DanielDalPra/Mundo-Senai-IOT/referencias/Código da Maquete - Estoque Inteligente.docx

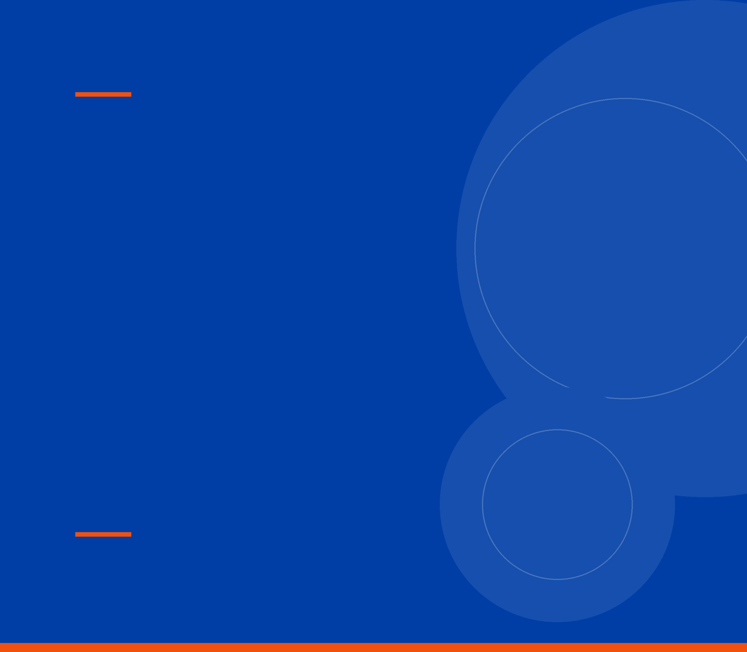
[picture p2: figure]
Fundo azul decorativo da capa

SERVIÇO NACIONAL DE APRENDIZAGEM INDUSTRIAL

Código
da Maquete

Estoque Inteligente com ESP32
Código-fonte e tabela de conexões

UNIDADE

Chapecó

CURSO

Técnico de Desenvolvimento de Sistemas

ALUNOS

Ana Júlia Cabral dos Santos, Crisbeth León, Catherine Bolivar, Mariana Lehr de Oliveira e Yoná Hellen de Sousa

DOCENTE

Rafaela Moreno

Chapecó

2026

# 1. Visão geral

Este documento reúne o código do ESP32 do projeto Estoque Inteligente e a tabela geral de conexões da maquete. O código é apresentado exatamente como foi desenvolvido pelo grupo, sem nenhuma alteração, e mantém o padrão de cores do arquivo original.

Item | Descrição
Microcontrolador | ESP32
Linguagem | C/C++ (Arduino)
Bibliotecas | SPI, Adafruit GFX, Adafruit SSD1306 e MFRC522
Periféricos | Display OLED SSD1306 (SPI), leitor RFID RC522 (SPI), ultrassônico HC-SR04 e sensor de cor TCS3200
Monitor Serial | 115200 baud
Intervalos de leitura | Ultrassônico: 500 ms · Cor: 1000 ms · RFID: 300 ms
Tamanho do código | 234 linhas

# 2. Tabela geral de conexões do ESP32

Componente | Pino no Componente | Pino no ESP32 | Tipo / Função Eletrônica | Status no Projeto
Alimentação Geral | VCC (Geral) | 3V3 ou 5V (Ver nota) | Alimentação Positiva | Obrigatório
| GND (Geral) | GND | Terra / Negativo Comum | Obrigatório
Display OLED (SPI) | CLK / D0 | GPIO 18 | SPI Clock (Compartilhado) | Sua ligação exata
| MOSI / DATA / D1 | GPIO 23 | SPI MOSI (Compartilhado) | Sua ligação exata
| CS | GPIO 4 | Chip Select (Exclusivo OLED) | Sua ligação exata
| DC | GPIO 27 | Data/Command (Exclusivo OLED) | Sua ligação exata
| RES / RESET | Nenhum (ou RST/EN) | Reset por Hardware (Opcional) | Definido como flutuante/=-1
Leitor RFID (SPI) | SCK / CLK | GPIO 18 | SPI Clock (Compartilhado) | Ligação compartilhada
| MOSI | GPIO 23 | SPI MOSI (Compartilhado) | Ligação compartilhada
| MISO | GPIO 19 | SPI MISO (Exclusivo RFID) | Obrigatório p/ retorno de dados
| SDA / CS | GPIO 12 | Chip Select (Exclusivo RFID) | Sugerido livre
| RST | GPIO 14 | Reset de Hardware (Exclusivo) | Sugerido livre
Ultrassônico (HC-SR04) | TRIG | GPIO 15 (D15) | Saída Digital (Pulso de disparo) | Sua ligação final
| ECHO | GPIO 26 (D26) | Entrada Digital (Retorno do eco) | Sua ligação final
Sensor de Cor (TCS3200) | S0 | GPIO 32 | Saída Digital (Escala de Frequência) | Sugerido livre
| S1 | GPIO 33 | Saída Digital (Escala de Frequência) | Sugerido livre
| S2 | GPIO 25 | Saída Digital (Seleção de Filtro) | Sugerido livre
| S3 | GPIO 13 | Saída Digital (Seleção de Filtro) | Sugerido livre
| OUT | GPIO 34 | Entrada Digital Pura (Leitura Freq.) | Sugerido livre (Input-only)
| LED | 3V3 ou GND | Alimentação dos LEDs integrados | Apenas um lado (Sua escolha)

# 3. Código-fonte

O código abaixo está idêntico ao do arquivo original, com o mesmo padrão de cores.

Cor | Exemplo | Elemento
■■■ | #include, if | Diretivas e comandos de controle
■■■ | int, float, void | Tipos de dados e modificadores
■■■ | Serial, digitalWrite | Funções, objetos e constantes
■■■ | 500, "VERMELHO" | Números e textos
■■■ | // comentário | Comentários
■■■ | x = y; ( ) { } | Variáveis, operadores e pontuação

#include <SPI.h>

#include <Adafruit_GFX.h>

#include <Adafruit_SSD1306.h>

#include <MFRC522.h>

// --- Configurações do Display OLED SPI ---

#define SCREEN_WIDTH 128

#define SCREEN_HEIGHT 64

#define OLED_MOSI 23

#define OLED_CLK 18

#define OLED_DC 27

#define OLED_CS 4

#define OLED_RESET -1

Adafruit_SSD1306 display(SCREEN_WIDTH, SCREEN_HEIGHT, &SPI, OLED_DC, OLED_RESET, OLED_CS);

// --- Configurações do Leitor RFID SPI ---

#define RFID_SDA_CS 12

#define RFID_RST 14

#define SPI_MISO 19

MFRC522 rfid(RFID_SDA_CS, RFID_RST);

// --- Configurações do Sensor Ultrassônico HC-SR04 ---

const int trigPin = 15;

const int echoPin = 26;

#define SOUND_SPEED 0.034

// --- Configurações do Sensor de Cor TCS3200 ---

#define S0 32

#define S1 33

#define S2 25

#define S3 13

#define sensorOut 34 // GPIO 34 é perfeito pois é uma entrada pura (Input-only)

// Variáveis para armazenar as frequências lidas pelo TCS3200

int frequenciaVermelho = 0;

int frequenciaVerde = 0;

int frequenciaAzul = 0;

// --- Variáveis de controle de tempo com millis() ---

unsigned long tempoAnteriorUltrassonico = 0;

const long intervaloUltrassonico = 500;

unsigned long tempoAnteriorRFID = 0;

const long intervaloRFID = 300;

unsigned long tempoAnteriorCor = 0;

const long intervaloCor = 1000; // Lê a cor a cada 1 segundo quando a caixa estiver presente

bool caixaPresente = false;

String corDetectada = "Nenhuma";

void setup() {

Serial.begin(115200);

// Inicializa o barramento SPI

SPI.begin(OLED_CLK, SPI_MISO, OLED_MOSI, -1);

// Inicialização do Display OLED

if(!display.begin(SSD1306_SWITCHCAPVCC)) {

Serial.println(F("Falha ao inicializar o display SSD1306"));

for(;;);

}

// Inicialização do Leitor RFID

rfid.PCD_Init();

// Inicialização dos pinos do Ultrassônico

pinMode(trigPin, OUTPUT);

pinMode(echoPin, INPUT);

// Inicialização dos pinos do TCS3200

pinMode(S0, OUTPUT);

pinMode(S1, OUTPUT);

pinMode(S2, OUTPUT);

pinMode(S3, OUTPUT);

pinMode(sensorOut, INPUT);

// Configura a escala de frequência do TCS3200 para 20% (S0 HIGH, S1 LOW)

// É a escala ideal e mais estável para leitura no ESP32

digitalWrite(S0, HIGH);

digitalWrite(S1, LOW);

// Tela Inicial

display.clearDisplay();

display.setTextSize(1);

display.setTextColor(SSD1306_WHITE);

display.setCursor(10, 25);

display.println("AGUARDANDO CAIXA...");

display.display();

}

void loop() {

unsigned long tempoAtual = millis();

// 1. Controle de tempo do Ultrassônico (A cada 500ms)

if (tempoAtual - tempoAnteriorUltrassonico >= intervaloUltrassonico) {

tempoAnteriorUltrassonico = tempoAtual;

float distancia = lerDistancia();

if (distancia > 0 && distancia < 4.0) {

if (!caixaPresente) {

caixaPresente = true;

Serial.println("Caixa detectada!");

atualizarDisplayMensagem("CAIXA DETECTADA", "Processando item...");

}

} else {

if (caixaPresente) {

caixaPresente = false;

corDetectada = "Nenhuma";

Serial.println("Caixa removida.");

atualizarDisplayMensagem("ESTOQUE LIVRE", "Aguardando caixa...");

}

}

}

// Se a caixa estiver presente na vaga, ativa as outras leituras de forma ritmada

if (caixaPresente) {

// 2. Leitura do Sensor de Cor (A cada 1 segundo)

if (tempoAtual - tempoAnteriorCor >= intervaloCor) {

tempoAnteriorCor = tempoAtual;

corDetectada = lerCorTCS3200();

// Atualiza a tela mostrando que a caixa está presente e exibindo a cor atualizada

atualizarDisplayMensagem("CAIXA NA VAGA", "Cor: " + corDetectada + "\nAproxime o RFID...");

}

// 3. Leitura do RFID (A cada 300ms)

if (tempoAtual - tempoAnteriorRFID >= intervaloRFID) {

tempoAnteriorRFID = tempoAtual;

lerRFID();

}

}

}

// ==========================================

// FUNÇÃO PARA ATUALIZAR MENSAGENS NO OLED

// ==========================================

void atualizarDisplayMensagem(String titulo, String subtitulo) {

display.clearDisplay();

display.setTextSize(1);

display.setCursor(0, 10);

display.println(titulo);

display.drawFastHLine(0, 25, 128, SSD1306_WHITE);

display.setCursor(0, 35);

display.println(subtitulo);

display.display();

}

// ==========================================

// FUNÇÃO PARA LER O SENSOR ULTRASSÔNICO

// ==========================================

float lerDistancia() {

digitalWrite(trigPin, LOW);

delayMicroseconds(2);

digitalWrite(trigPin, HIGH);

delayMicroseconds(10);

digitalWrite(trigPin, LOW);

long duracao = pulseIn(echoPin, HIGH, 26000);

if (duracao == 0) return -1.0;

return (duracao * SOUND_SPEED) / 2.0;

}

// ==========================================

// FUNÇÃO PARA LER O SENSOR DE COR TCS3200

// ==========================================

String lerCorTCS3200() {

// Nota: Menor frequência calculada pelo pulseIn significa maior intensidade daquela cor.

// Configura filtro Vermelho (S2 LOW, S3 LOW)

digitalWrite(S2, LOW);

digitalWrite(S3, LOW);

frequenciaVermelho = pulseIn(sensorOut, LOW, 20000); // timeout de 20ms

// Configura filtro Verde (S2 HIGH, S3 HIGH)

digitalWrite(S2, HIGH);

digitalWrite(S3, HIGH);

frequenciaVerde = pulseIn(sensorOut, LOW, 20000);

// Configura filtro Azul (S2 LOW, S3 HIGH)

digitalWrite(S2, LOW);

digitalWrite(S3, HIGH);

frequenciaAzul = pulseIn(sensorOut, LOW, 20000);

// --- LÓGICA DE CALIBRAÇÃO E IDENTIFICAÇÃO ---

// IMPORTANTE: Você precisará ajustar os valores abaixo olhando o Monitor Serial,

// pois a iluminação do ambiente altera muito o comportamento do TCS3200.

Serial.print("R: "); Serial.print(frequenciaVermelho);

Serial.print(" | G: "); Serial.print(frequenciaVerde);

Serial.print(" | B: "); Serial.println(frequenciaAzul);

// Exemplo básico de decisão lógica de cor baseado no menor valor de frequência (predominância)

if (frequenciaVermelho < frequenciaVerde && frequenciaVermelho < frequenciaAzul) {

return "VERMELHO";

}

else if (frequenciaAzul < frequenciaVermelho && frequenciaAzul < frequenciaVerde) {

return "AZUL";

}

else if (frequenciaVerde < frequenciaVermelho && frequenciaVerde < frequenciaAzul) {

return "VERDE";

}

return "Indefinida";

}

// ==========================================

// FUNÇÃO PARA LER O LEITOR RFID

// ==========================================

void lerRFID() {

if ( ! rfid.PICC_IsNewCardPresent()) return;

if ( ! rfid.PICC_ReadCardSerial()) return;

Serial.print("Tag RFID Detectada! UID: ");

String uidString = "";

for (byte i = 0; i < rfid.uid.size; i++) {

uidString += String(rfid.uid.uidByte[i] < 0x10 ? " 0" : " ");

uidString += String(rfid.uid.uidByte[i], HEX);

}

uidString.toUpperCase();

Serial.println(uidString);

// Quando ler o RFID, mostra o UID junto com a cor que já estava armazenada

atualizarDisplayMensagem("TAG LIDA!", "UID:" + uidString + "\nCor: " + corDetectada);

rfid.PICC_HaltA();

rfid.PCD_StopCrypto1();

}

Código-fonte do sistema

SENAI Código da maquete · Estoque Inteligente
