DanielDalPra/Mundo-Senai-IOT/docs/esp32-usb-conectado.png

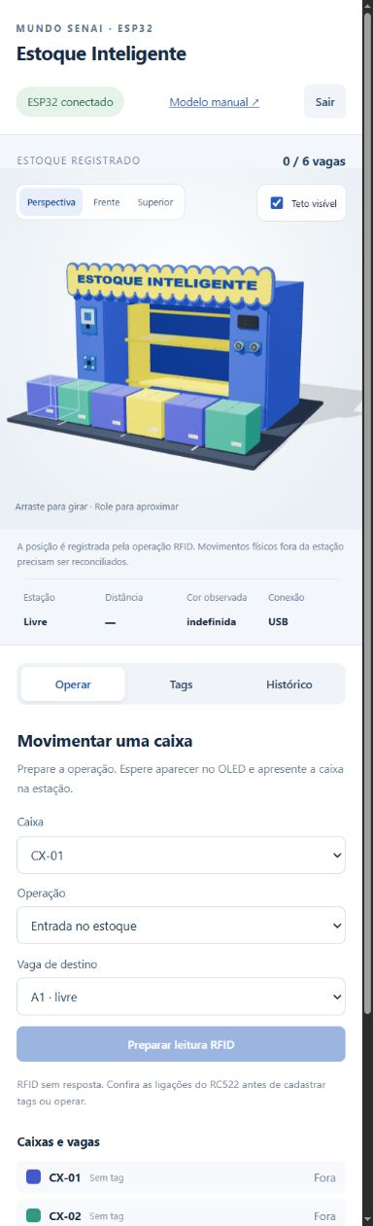
docs/esp32-usb-conectado.png
