DanielDalPra/Mundo-Senai-IOT/referencias/fotos-maquete/WhatsApp Image 2026-10-21 at 19.43.03.jpeg

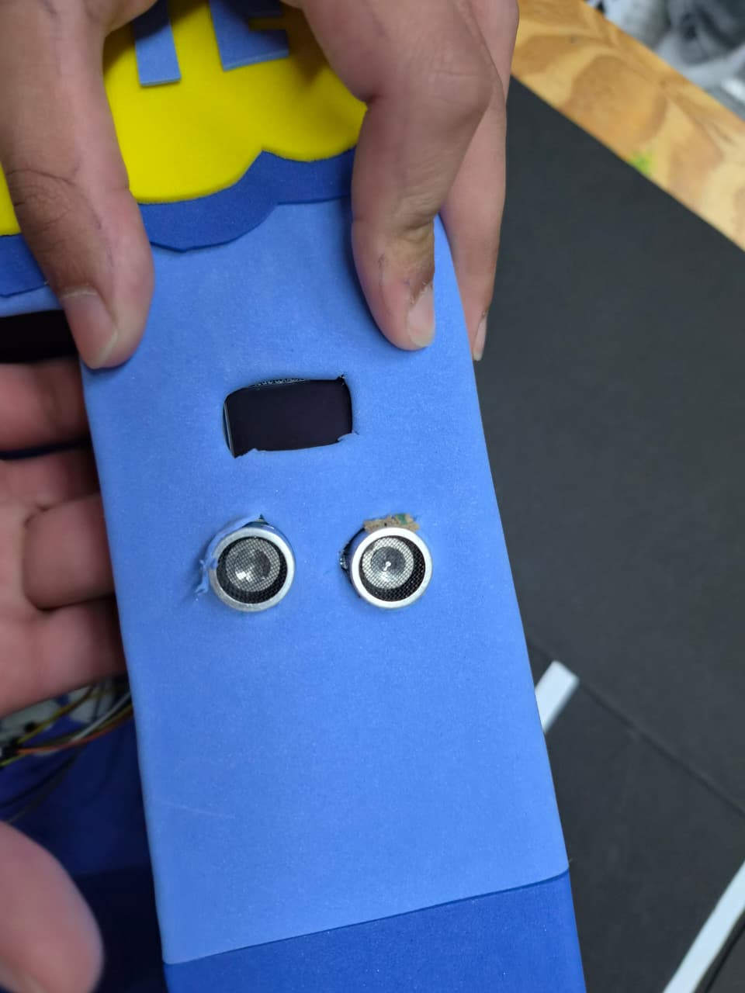
referencias/fotos-maquete/WhatsApp Image 2026-10-21 at 19.43.03.jpeg
