DanielDalPra/Mundo-Senai-IOT/referencias/componentes/WhatsApp Image 2026-10-21 at 19.54.55.jpeg

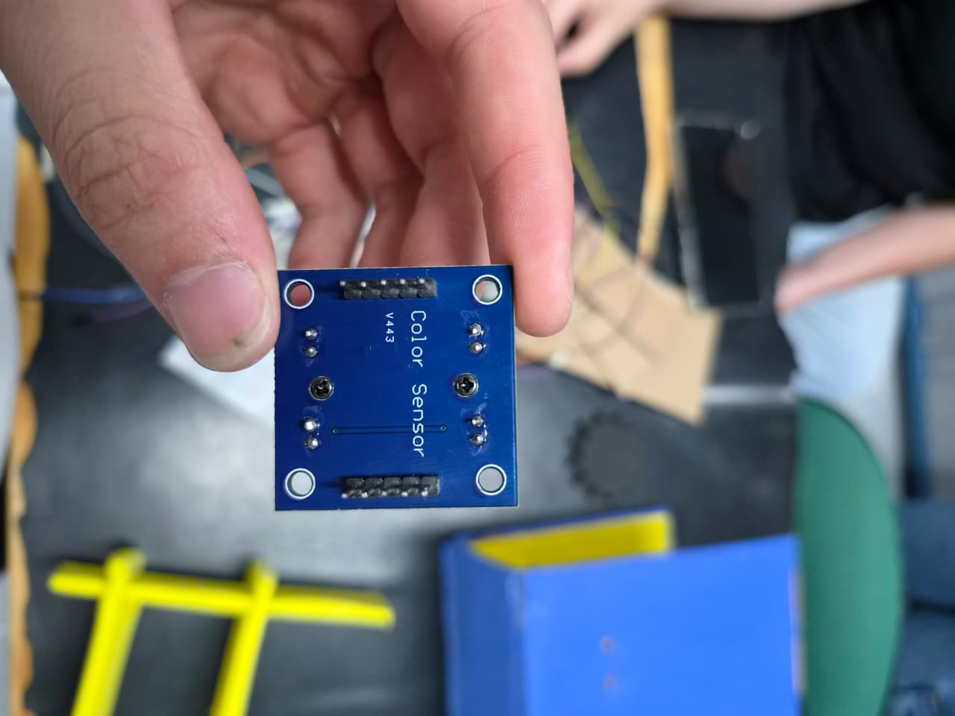
referencias/componentes/WhatsApp Image 2026-10-21 at 19.54.55.jpeg
