DanielDalPra/Mundo-Senai-IOT/docs/montagem-fiel.png

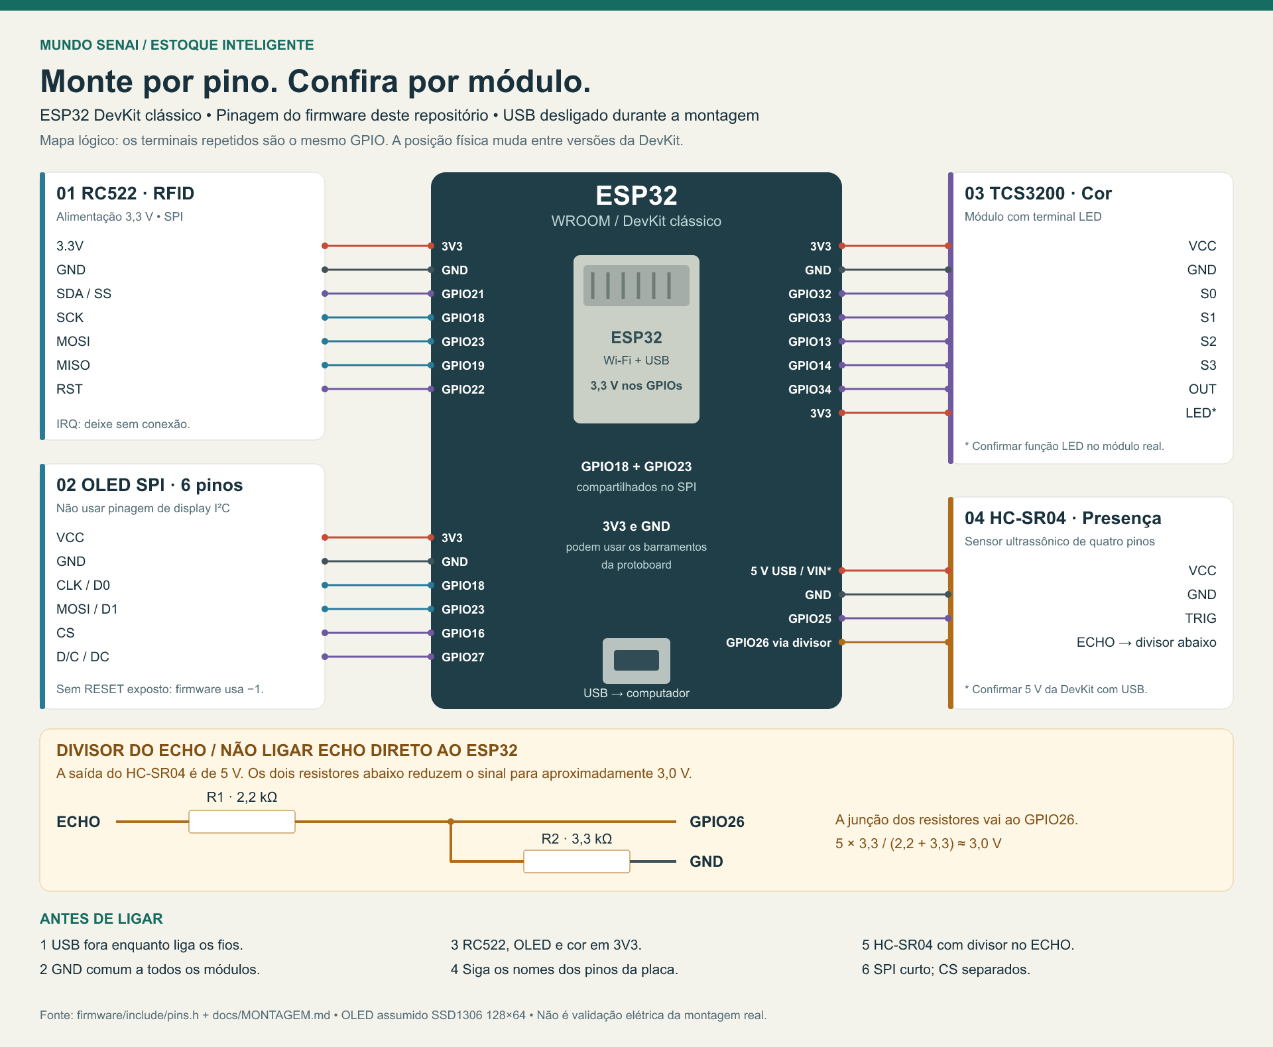
docs/montagem-fiel.png
