DanielDalPra/Mundo-Senai-IOT/simulation/wokwi/circuito-testado.png

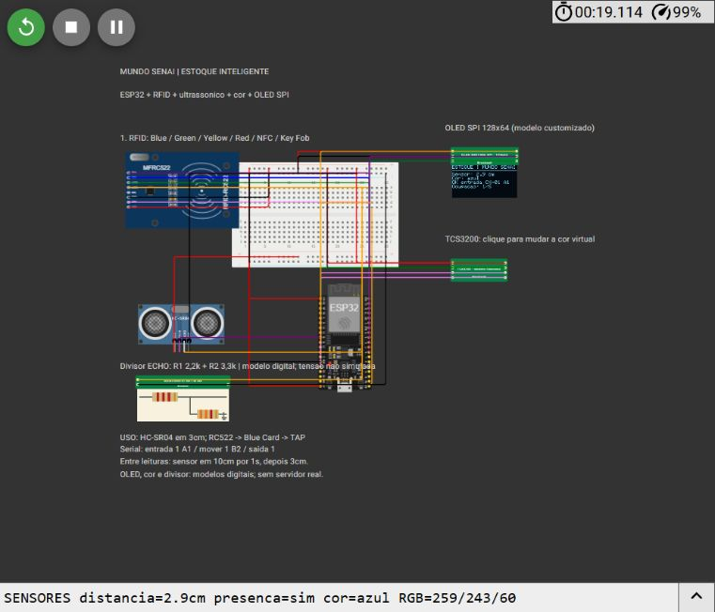
simulation/wokwi/circuito-testado.png
