DanielDalPra/Mundo-Senai-IOT/simulation/wokwi/teste-rfid.png

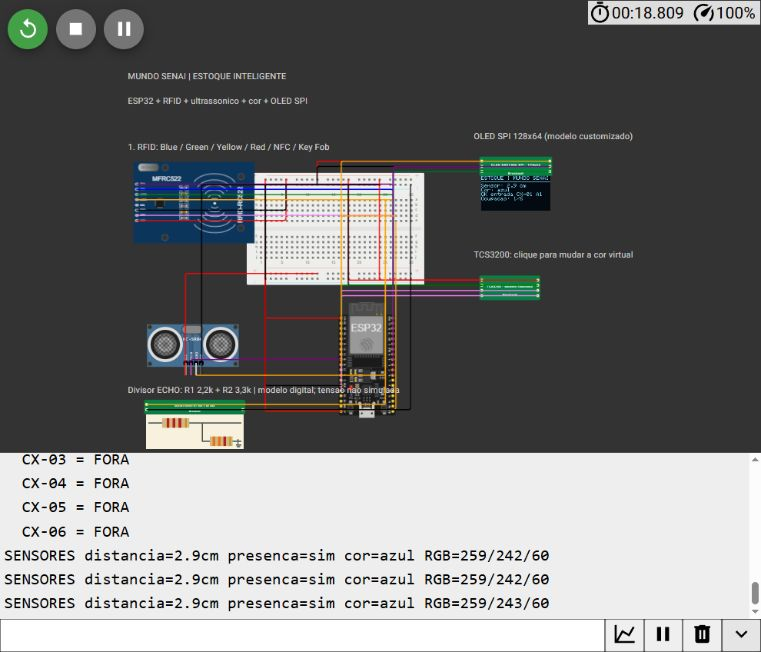
simulation/wokwi/teste-rfid.png
