DanielDalPra/Mundo-Senai-IOT/(commit log)

2026-10-22 Implementa estoque IoT com ESP32, servidor, painel 3D e manual de montagem
2026-11-01 Adiciona transporte USB, simulacao e validacao do firmware ESP32
2026-11-02 Adiciona teste isolado de cor e calibracao do TCS3200
